masahirosuzuka/GC3/gc3.kicad_pcb

## KiCad design gc3.kicad_pcb (2017-02-18)

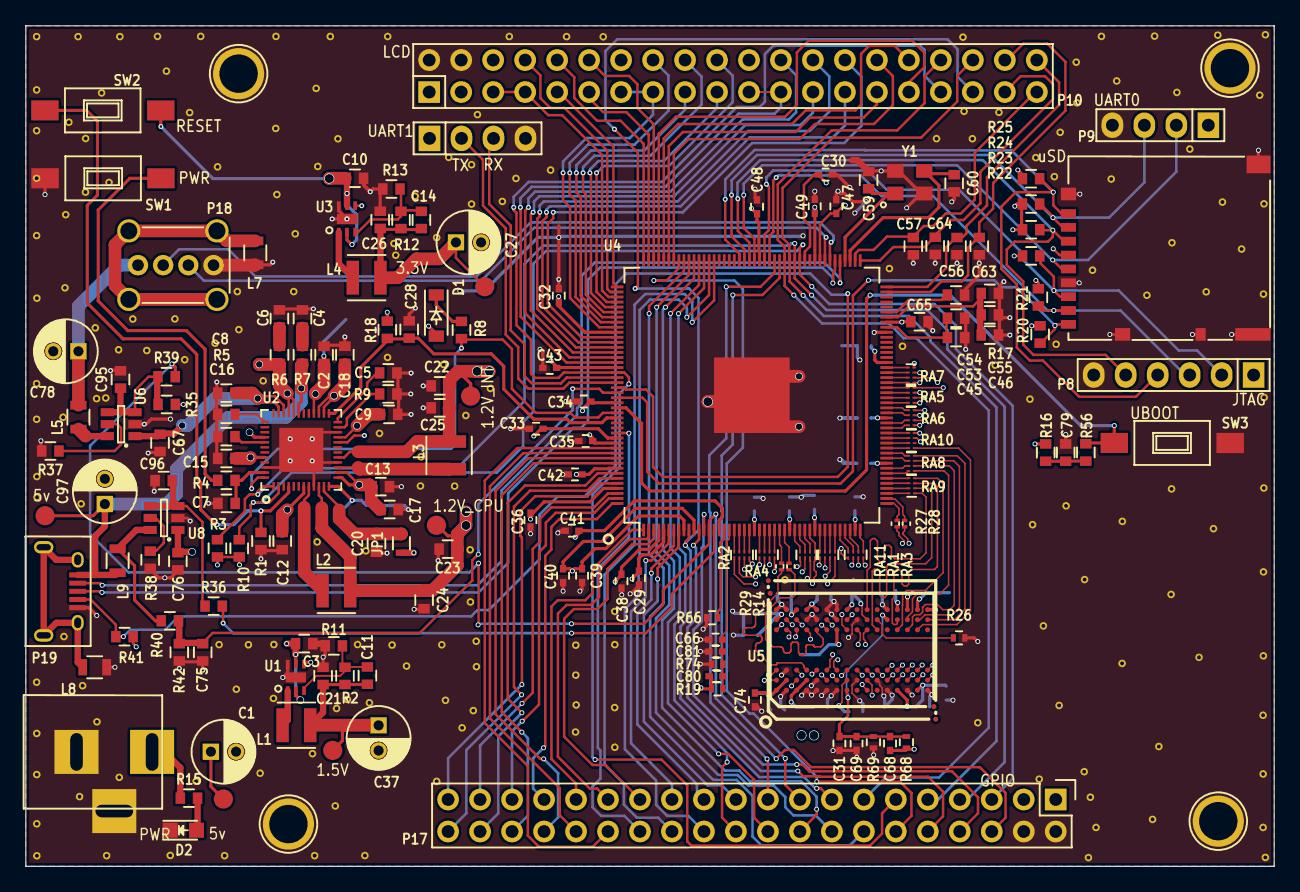
[picture p1: board gc3.kicad_pcb from above]

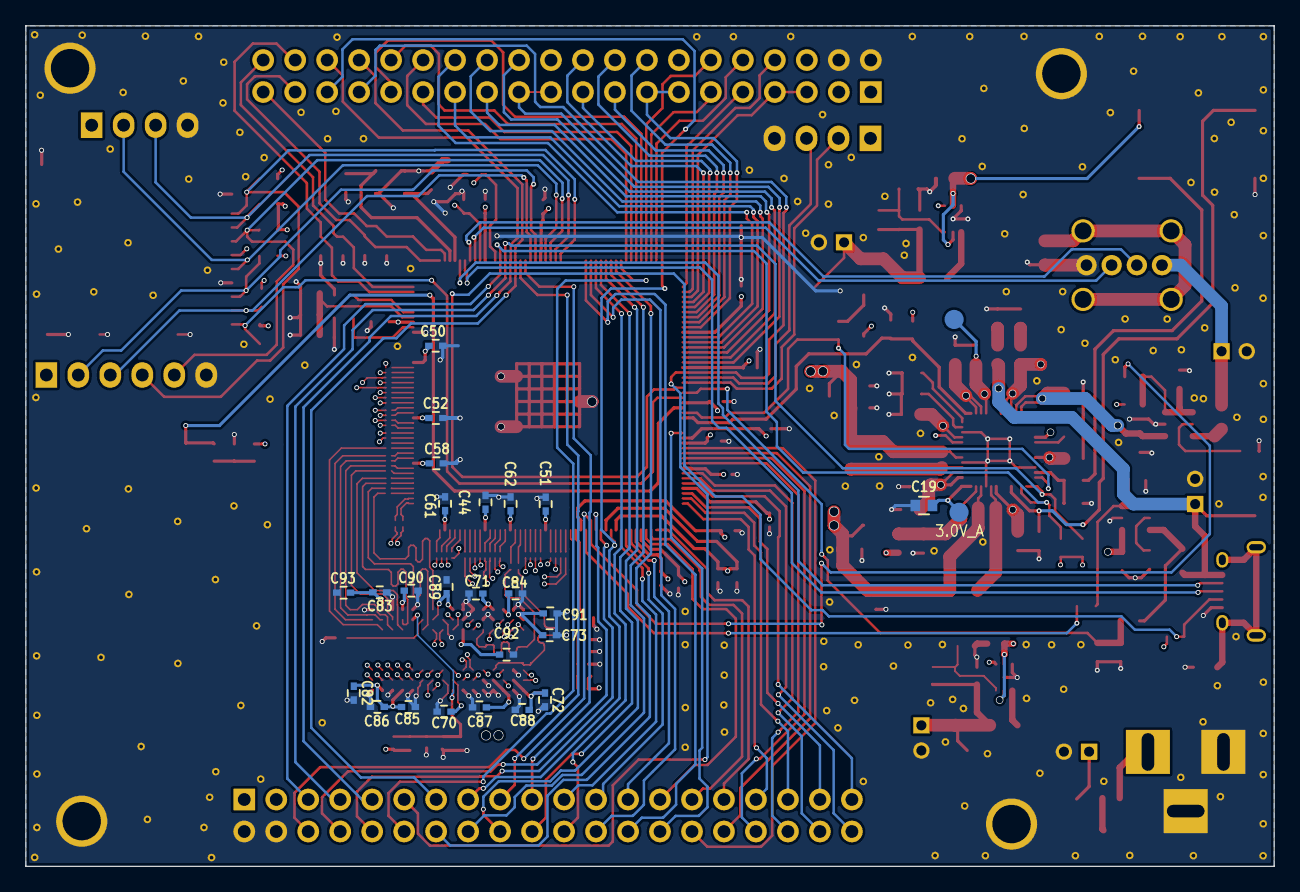
[picture p2: board gc3.kicad_pcb from below]

Board: 6 copper layers, 99.1 x 66.8 mm, 191 parts (26 on the bottom side), 225 nets.

Parts:
C1, C27, C37, C78, C97: 100uF; C_Radial_D5_L11_P2
C2, C9, C56, C57, C63, C64, C79: 1uF; Common_0603
C3, C10: 4.7uF; Common_0603
C4, C5, C6, C8, C12, C13, C15, C16, C17, C18, C19, C20, C22, C23, C55: 10uF/6.3V; Common_0603
C7, C24, C25: 1nF; Common_0603
C11, C14: 22pF; Common_0603
C21, C26: 10uF; Common_0603
C28, C67, C75, C76, C95, C96: 0.1uF; Common_0603
C29, C30, C32, C33, C34, C35, C38, C40, C43, C44, C52, C61: 0.1uF/6.3V; C_0402
C31, C47, C66, C68, C69, C70, C71, C72, C73, C74, C80, C81, C83, C84, C85, C86, C88, C89, C90, C91, C92, C93: 0.1uF; C_0402
C36, C39, C41, C48, C50, C58, C62: 10uF/6.3V; C_0402
C42, C49, C51, C82, C87: 22uF/6.3V; C_0402
C45, C46, C53, C54: 0.1uF/6.3V; Common_0603
C59, C60: 30pF; Common_0603
C65: 22uF/6.3V; Common_0603
D1: DIODE; SOD-123
D2: POWER; LED-0805
J1: JACK; BARREL_JACK
J2: DM3AT-SF-PEJM5
JP1: JUMPER; R_0603
L1, L2, L3, L4: 2.2uH; Neosid_Inductor_SMS-ME3015
L5, L7, L8, L9: FB/2A; R_0805
P1, P2, P3, P4, P5, P6, P15: TESTPOINT; Measurement_Point_Round-SMD-Pad_Small
P7: LCD; Pin_Header_Straight_2x20
P8: JTAG; Pin_Header_Straight_1x06
P9: UART0; Pin_Header_Straight_1x04
P10: UART1; Pin_Header_Straight_1x04
P11, P12, P13, P14: GND; 1pin
P16: TEESTPOINT; Measurement_Point_Round-SMD-Pad_Small
P17: GPIO; Pin_Header_Straight_2x20
P18: USB_A; USB_A_Vertical
P19: USB_OTG; USB_Micro-B
R1: 510R; Common_0603
R2: 315k; Common_0603
R3, R10: 2.2k; Common_0603
R4: 1k; Common_0603
R5: 240R/1%; Common_0603
R6, R7: 1R; Common_0603
R8, R18, R20, R21, R22, R23, R24, R25, R35, R41: 47k; Common_0603
R9, R17: 200k/1%; Common_0603
R11: 210k; Common_0603
R12, R36, R39: 100k; Common_0603
R13: 22k; Common_0603
R14, R29: 22R; R_0201
R15: 90R; Common_0603
R16: 100k/1%; Common_0603
R19, R68, R69, R74: 2k/1%; R_0402
R26, R66: 240R/1%; R_0402
R27, R28: 24R; R_0201
R37, R38: 20k; Common_0603
R40: 47K; Common_0603
R42: 100K; Common_0603
R56: 6.8k/1%; Common_0603
RA1, RA2, RA3, RA4, RA5, RA6, RA7, RA8, RA9, RA10, RA11: 22R; EXB18V
SW1: PWR_ON; SW_SPST_FSMSM
SW2: RESET; SW_SPST_FSMSM
SW3: UBOOT; SW_SPST_FSMSM
U1, U3: TPS62290
U2: axp209; TQFP-48-1EP_6x6mm_Pitch0.4mm
U4: a13; LQFP-176_20x20mm_Pitch0.4mm
U5: h5tq2g63bfr; FBGA96(HYNIX_SAMSUNG_512MX16_DDR3)
U6, U8: TPS2552; SOT-23-6
Y1: 24MHz/20pF/20ppm; ecx32

Connections:
1.2V_CPU: C23.1, C24.1, C34.1, C35.1, C36.1, C38.1, C39.1, C40.1, C41.1, C42.1, L2.2, P4.1, U2.10, U4.4, U4.9, U4.11, U4.16, U4.156, U4.164, U4.169, U4.173
1.2V_INT: C22.1, C25.1, C43.1, C44.1, C48.1, C49.1, C50.1, L3.2, P5.1, U2.17, U4.35, U4.73, U4.98, U4.109, U4.149
+1.5V: C11.1, C21.1, C37.1, C51.1, C52.1, C58.1, C61.1, C62.1, C68.1, C70.1, C71.1, C72.1, C73.1, C74.1, C80.1, C82.1, C83.1, C84.1, C85.1, C86.1, C87.1, C88.1, C89.1, C90.1, C91.1, C92.1, C93.1, L1.2, P6.1, R2.1, R19.1, R68.1, U4.23, U4.30, U4.43, U4.53, U4.62, U5.A1, U5.A8, U5.B2, U5.C1, U5.C9, U5.D2, U5.D9, U5.E9, U5.G7, U5.H2, U5.H9, U5.K2, U5.K8, U5.N1, U5.N9, U5.R1, U5.R9
+3.0VA: C19.2, C65.1, P3.1, R16.2, U1.4, U2.12, U4.81
+3V3: C14.1, C26.1, C27.1, C29.1, C30.1, C32.1, C33.1, C47.1, D1.2, J2.4, JP1.1, L4.2, P7.3, P8.1, P9.1, P10.1, P15.1, P17.3, R3.2, R10.2, R12.1, R18.2, R20.1, R21.1, R22.1, R23.1, R24.1, R25.1, R35.2, R41.1, U4.5, U4.97, U4.100, U4.142, U4.163
+5V: C1.1, J1.1, P7.1, P16.1, P17.1, R6.1, R15.1, U2.32, U2.33
/3V3_WIFI: C16.2, U2.41
/+5V_USB_OTG: C97.1, L9.2, P1.1, P19.1, R7.1, U2.31
/EXTEN: U2.20, U3.4
/NMI_N: R8.1, U2.48, U4.158
/RESET_N: C28.1, R18.1, U2.25, U4.159
/VDD_RTC: C18.2, P2.1, U2.28
/VINT: C2.1, U2.26, U2.27
/mpu_ddr3/A0: RA6.5, U5.N3
/mpu_ddr3/A1: RA8.7, U5.P7
/mpu_ddr3/A2: RA5.7, U5.P3
/mpu_ddr3/A3: RA5.8, U5.N2
/mpu_ddr3/A4: RA8.8, U5.P8
/mpu_ddr3/A5: RA5.6, U5.P2
/mpu_ddr3/A6: RA8.6, U5.R8
/mpu_ddr3/A7: RA7.6, U5.R2
/mpu_ddr3/A8: RA8.5, U5.T8
/mpu_ddr3/A9: RA7.8, U5.R3
/mpu_ddr3/A10: RA9.7, U5.L7
/mpu_ddr3/A11: RA10.8, U5.R7
/mpu_ddr3/A12: RA9.5, U5.N7
/mpu_ddr3/A13: RA5.5, U5.T3
/mpu_ddr3/BA0: RA6.6, U5.M2
/mpu_ddr3/BA1: RA9.6, U5.N8
/mpu_ddr3/BA2: RA6.7, U5.M3
/mpu_ddr3/CAS: RA10.5, U5.K3
/mpu_ddr3/CKE: RA9.8, U5.K9
/mpu_ddr3/CK_N: R28.1, U5.K7
/mpu_ddr3/CK_P: R27.1, U5.J7
/mpu_ddr3/D0: RA2.1, U5.E3
/mpu_ddr3/D1: RA3.8, U5.F7
/mpu_ddr3/D2: RA2.2, U5.F2
/mpu_ddr3/D3: RA3.7, U5.F8
/mpu_ddr3/D4: RA2.4, U5.H3
/mpu_ddr3/D5: RA3.5, U5.H8
/mpu_ddr3/D6: RA2.3, U5.G2
/mpu_ddr3/D7: RA3.6, U5.H7
/mpu_ddr3/D8: RA1.7, U5.D7
/mpu_ddr3/D9: RA4.7, U5.C3
/mpu_ddr3/D10: RA1.5, U5.C8
/mpu_ddr3/D11: RA4.8, U5.C2
/mpu_ddr3/D12: RA1.8, U5.A7
/mpu_ddr3/D13: RA4.6, U5.A2
/mpu_ddr3/D14: RA1.6, U5.B8
/mpu_ddr3/D15: RA4.5, U5.A3
/mpu_ddr3/DM0: R14.1, U5.E7
/mpu_ddr3/DM1: R29.1, U5.D3
/mpu_ddr3/DQS0_N: RA11.7, U5.G3
/mpu_ddr3/DQS0_P: RA11.8, U5.F3
/mpu_ddr3/DQS1_N: RA11.5, U5.B7
/mpu_ddr3/DQS1_P: RA11.6, U5.C7
/mpu_ddr3/LCD_CLK: P7.31, U4.129
/mpu_ddr3/LCD_D2: P7.21, P7.23, U4.148
/mpu_ddr3/LCD_D3: P7.24, U4.147
/mpu_ddr3/LCD_D4: P7.25, U4.146
/mpu_ddr3/LCD_D5: P7.26, U4.145
/mpu_ddr3/LCD_D6: P7.27, U4.144
/mpu_ddr3/LCD_D7: P7.28, U4.143
/mpu_ddr3/LCD_D10: P7.13, P7.15, U4.141
/mpu_ddr3/LCD_D11: P7.16, U4.140
/mpu_ddr3/LCD_D12: P7.17, U4.139
/mpu_ddr3/LCD_D13: P7.18, U4.138
/mpu_ddr3/LCD_D14: P7.19, U4.137
/mpu_ddr3/LCD_D15: P7.20, U4.136
/mpu_ddr3/LCD_D18: P7.5, P7.7, U4.135
/mpu_ddr3/LCD_D19: P7.8, U4.134
/mpu_ddr3/LCD_D20: P7.9, U4.133
/mpu_ddr3/LCD_D21: P7.10, U4.132
/mpu_ddr3/LCD_D22: P7.11, U4.131
/mpu_ddr3/LCD_D23: P7.12, U4.130
/mpu_ddr3/LCD_DE: P7.32, U4.128
/mpu_ddr3/LCD_HSYNC: P7.29, U4.127
/mpu_ddr3/LCD_VSYNC: P7.30, U4.126
/mpu_ddr3/ODT: RA7.5, U5.K1
/mpu_ddr3/PIN6/PWM0: P7.36, P17.9, U4.103
/mpu_ddr3/PIN7: P7.33, P17.11, U4.150
/mpu_ddr3/PIN8: P7.34, P17.13, U4.104
/mpu_ddr3/PIN9: P7.35, P17.15, U4.10
/mpu_ddr3/PIN10/TWI1-SCK: P17.17, U4.105
/mpu_ddr3/PIN11/TWI1-SDA: P17.19, U4.106
/mpu_ddr3/PIN12/NWE: P17.21, U4.8
/mpu_ddr3/PIN13/NALE: P17.23, U4.7
/mpu_ddr3/PIN14/NCLE: P17.25, U4.6
/mpu_ddr3/PIN15/NCE1: P17.27, U4.3
/mpu_ddr3/PIN16/NCE0: P17.29, U4.2
/mpu_ddr3/PIN17/NRE: P17.31, U4.1
/mpu_ddr3/PIN18/NRB0: P17.33, U4.176
/mpu_ddr3/PIN19/NRB1: P17.35, U4.175
/mpu_ddr3/PIN20/NDQ0: P17.37, U4.174
/mpu_ddr3/PIN21/NDQ1: P17.39, U4.172
/mpu_ddr3/PIN22/NDQ2: P17.40, U4.171
/mpu_ddr3/PIN23/NDQ3: P17.38, U4.170
/mpu_ddr3/PIN24/NDQ4: P17.36, U4.168
/mpu_ddr3/PIN25/NDQ5: P17.34, U4.167
/mpu_ddr3/PIN26/NDQ6: P17.32, U4.166
/mpu_ddr3/PIN27/NDQ7: P17.30, U4.165
/mpu_ddr3/PIN28/NDQS: P17.28, U4.162
/mpu_ddr3/PIN29: P17.26, U4.118
/mpu_ddr3/PIN30: P17.24, U4.119
/mpu_ddr3/PIN31: P17.22, U4.120
/mpu_ddr3/PIN32: P17.20, U4.121
/mpu_ddr3/PIN33: P17.18, U4.122
/mpu_ddr3/PIN34: P17.16, U4.123
/mpu_ddr3/PIN35: P17.14, U4.124
/mpu_ddr3/PIN36: P17.12, U4.125
/mpu_ddr3/PIN37: P17.10, U4.12
/mpu_ddr3/PIN38/VGA_DIS: P17.8, U4.13
/mpu_ddr3/PIN39/USBH_EN: P17.6, R39.2, U4.14
/mpu_ddr3/RAS: RA10.6, U5.J3
/mpu_ddr3/RESET: RA7.7, U5.T2
/mpu_ddr3/SA0: RA6.4, U4.64
/mpu_ddr3/SA1: RA8.2, U4.52
/mpu_ddr3/SA2: RA5.2, U4.66
/mpu_ddr3/SA3: RA5.1, U4.65
/mpu_ddr3/SA4: RA8.1, U4.51
/mpu_ddr3/SA5: RA5.3, U4.67
/mpu_ddr3/SA6: RA8.3, U4.54
/mpu_ddr3/SA7: RA7.3, U4.71
/mpu_ddr3/SA8: RA8.4, U4.55
/mpu_ddr3/SA9: RA7.1, U4.69
/mpu_ddr3/SA10: RA9.2, U4.48
/mpu_ddr3/SA11: RA10.1, U4.56
/mpu_ddr3/SA12: RA9.4, U4.50
/mpu_ddr3/SA13: RA5.4, U4.68
/mpu_ddr3/SA14: RA10.2, U4.57
/mpu_ddr3/SBA0: RA6.3, U4.63
/mpu_ddr3/SBA1: RA9.3, U4.49
/mpu_ddr3/SBA2: RA6.2, U4.61
/mpu_ddr3/SCAS: RA10.4, U4.59
/mpu_ddr3/SCKE: RA9.1, U4.47
/mpu_ddr3/SCK_N: R28.2, U4.46
/mpu_ddr3/SCK_P: R27.2, U4.45
/mpu_ddr3/SD0: RA2.8, U4.22
/mpu_ddr3/SD0_CARD_DETECT: J2.9, R20.2, U4.155
/mpu_ddr3/SD1: RA3.1, U4.40
/mpu_ddr3/SD2: RA2.7, U4.21
/mpu_ddr3/SD3: RA3.2, U4.41
/mpu_ddr3/SD4: RA2.5, U4.19
/mpu_ddr3/SD5: RA3.4, U4.44
/mpu_ddr3/SD6: RA2.6, U4.20
/mpu_ddr3/SD7: RA3.3, U4.42
/mpu_ddr3/SD8: RA1.2, U4.37
/mpu_ddr3/SD9: RA4.2, U4.25
/mpu_ddr3/SD10: RA1.4, U4.39
/mpu_ddr3/SD11: RA4.1, U4.24
/mpu_ddr3/SD12: RA1.1, U4.36
/mpu_ddr3/SD13: RA4.3, U4.26
/mpu_ddr3/SD14: RA1.3, U4.38
/mpu_ddr3/SD15: RA4.4, U4.27
/mpu_ddr3/SDC0_CMD: J2.3, P8.5, R23.2, U4.111
/mpu_ddr3/SDC0_DATA0: J2.7, P8.2, R22.2, U4.108
/mpu_ddr3/SDC0_DATA1: J2.8, P8.3, R21.2, U4.107
/mpu_ddr3/SDC0_DATA2: J2.1, P8.4, R25.2, U4.113
/mpu_ddr3/SDC0_DATA3: J2.2, P9.3, R24.2, U4.112
/mpu_ddr3/SDC0_SCK: J2.5, P9.2, U4.110
/mpu_ddr3/SDM0: R14.2, U4.29
/mpu_ddr3/SDM1: R29.2, U4.28
/mpu_ddr3/SDQS0_N: RA11.2, U4.32
/mpu_ddr3/SDQS0_P: RA11.1, U4.31
/mpu_ddr3/SDQS1_N: RA11.4, U4.34
/mpu_ddr3/SDQS1_P: RA11.3, U4.33
/mpu_ddr3/SODT: RA7.4, U4.72
/mpu_ddr3/SRAS: RA10.3, U4.58
/mpu_ddr3/SRESET: RA7.2, U4.70
/mpu_ddr3/SVREF: C66.2, C80.2, C81.1, R19.2, R74.1, U4.18
/mpu_ddr3/SWE: RA6.1, U4.60
/mpu_ddr3/TPX1: C64.1, P7.37, U4.89
/mpu_ddr3/TPX2: C63.1, P7.38, U4.87
/mpu_ddr3/TPY1: C57.1, P7.39, U4.90
/mpu_ddr3/TPY2: C56.1, P7.40, U4.88
/mpu_ddr3/UART1_RX: P10.3, U4.151
/mpu_ddr3/UART1_TX: P10.2, U4.152
/mpu_ddr3/UBOOT: R56.1, SW3.2, U4.157
/mpu_ddr3/UDM0: P19.2, U4.93
/mpu_ddr3/UDM1: P18.2, U4.95
/mpu_ddr3/UDP0: P19.3, U4.94
/mpu_ddr3/UDP1: P18.3, U4.96
/mpu_ddr3/USB0_DRV: R36.2, U4.15
/mpu_ddr3/USB0_IDDET: P19.4, R41.2, U4.153
/mpu_ddr3/USB0_VBUSDET: C75.1, R40.2, R42.1, U4.154
/mpu_ddr3/VREF: C31.1, C68.2, C69.1, R68.2, R69.1, U5.H1, U5.M8
/mpu_ddr3/WE: RA6.8, U5.L3
GND: C1.2, C2.2, C3.2, C4.2, C5.2, C6.2, C7.2, C8.2, C9.2, C10.2, C12.1, C13.1, C15.1, C16.1, C17.1, C18.1, C19.1, C20.1, C21.2, C22.2, C23.2, C24.2, C25.2, C26.2, C27.2, C28.2, C29.2, C30.2, C31.2, C32.2, C33.2, C34.2, C35.2, C36.2, C37.2, C38.2, C39.2, C40.2, C41.2, C42.2, C43.2, C44.2, C45.2, C46.2, C47.2, C48.2, C49.2, C50.2, C51.2, C52.2, C53.2, C54.2, C55.2, C56.2, C57.2, C58.2, C59.2, C60.2, C61.2, C62.2, C63.2, C64.2, C65.2, C66.1, C67.2, C69.2, C70.2, C71.2, C72.2, C73.2, C74.2, C75.2, C76.2, C78.2, C79.2, C81.2, C82.2, C83.2, C84.2, C85.2, C86.2, C87.2, C88.2, C89.2, C90.2, C91.2, C92.2, C93.2, C95.2, C96.2, C97.2, D2.1, J1.2, J1.3, J2.6, J2.10, J2.11, L7.1, L8.1, P7.2, P7.4, P8.6, P9.4, P10.4, P11.1, P12.1, P13.1, P14.1, P17.2, P17.4, P18.4, P19.5, R1.2, R5.2, R9.2, R11.2, R13.2, R17.2, R26.2, R37.2, R38.2, R42.2, R66.1, R69.2, R74.2, SW1.1, SW3.1, U1.6, U2.9, U2.16, U2.22, U2.46, U2.49, U3.6, U4.79, U4.177, U5.A9, U5.B1, U5.B3, U5.B9, U5.D1, U5.D8, U5.E1, U5.E2, U5.E8, U5.F1, U5.F9, U5.G1, U5.G8, U5.G9, U5.J2, U5.J8, U5.L2, U5.M1, U5.M9, U5.P1, U5.P9, U5.T1, U5.T9, U6.2, U8.2, Y1.2, Y1.4
IPSOUT: C3.1, C8.1, C9.1, C10.1, C12.2, C13.2, C15.2, C17.2, C67.1, C76.1, SW2.1, U1.2, U1.5, U2.7, U2.13, U2.14, U2.21, U2.34, U2.35, U2.40, U2.44, U3.2, U3.5, U6.1, U8.1
unnamed: C4.1, R7.2
unnamed: C5.1, U2.24
unnamed: C6.1, R6.2
unnamed: C7.1, R4.1, U2.47
unnamed: C11.2, R2.2, R11.1, U1.3
unnamed: C14.2, R12.2, R13.1, U3.3
unnamed: C20.2, JP1.2, U2.11
unnamed: C45.1, C53.1, U4.80
unnamed: C46.1, C55.1, R17.1, U4.82
unnamed: C54.1, U4.83
unnamed: C59.1, U4.92, Y1.1
unnamed: C60.1, U4.91, Y1.3
unnamed: C78.1, L5.2, P18.1
unnamed: C79.1, R16.1, R56.2
unnamed: C95.1, R35.1, R39.1, U6.3, U6.4
unnamed: C96.1, R36.1, U8.3, U8.4
unnamed: D1.1, R8.2
unnamed: D2.2, R15.2
unnamed: L1.1, U1.1
unnamed: L2.1, U2.8
unnamed: L3.1, U2.15
unnamed: L4.1, U3.1
unnamed: L5.1, U6.6
unnamed: L7.2, P18.5
unnamed: L8.2, P19.6
unnamed: L9.1, R40.1, U8.6
unnamed: R1.1, SW2.2, U2.4
unnamed: R4.2, SW1.2
unnamed: R5.1, U2.37
unnamed: R9.1, U2.23
unnamed: R26.1, U5.L8
unnamed: R37.1, U6.5
unnamed: R38.1, U8.5
unnamed: R66.2, U4.17
PIN4/TWI0-SCK: P17.5, R10.1, U2.2, U4.101
PIN5/TWI0-SDA: P17.7, R3.1, U2.1, U4.102
