masahirosuzuka/GC3/(commit log)

2015-10-07 clean sch and add resistor array
    [gc3.kicad_pcb, gc3.sch, mpu_ddr3.sch]
2016-04-02 commit before cleanup all footprint
    [gc3.kicad_pcb, gc3.sch, mpu_ddr3.sch]
2016-04-03 clean: all footprint
    [gc3.kicad_pcb, mpu_ddr3.sch]
2016-07-31 Fix : bug fix
    [gc3.kicad_pcb, gc3.sch, mpu_ddr3.sch]
2016-09-02 Temp : Temp commit for before Update4
    [gc3.kicad_pcb, gc3.sch, mpu_ddr3.sch]
2016-09-24 Temp : temo commit for finish DDR3 routing
    [gc3.kicad_pcb, mpu_ddr3.sch]
2016-10-02 Temp : temp commit, finish routing for Update4
    [gc3.kicad_pcb, mpu_ddr3.sch]
2016-10-10 Add : finish Update$
    [gc3.kicad_pcb, mpu_ddr3.sch]
2016-11-20 Commit before production Update4
    [gc3.csv, gc3.kicad_pcb, mpu_ddr3.sch]
2016-12-10 temp : commit before change 8 layer
    [gc3.kicad_pcb]
2017-02-17 Fix : fix line width for impedance matching
    [gc3.kicad_pcb, gc3.sch, mpu_ddr3.sch]
2017-02-18 Hotfix : Fix solid ground issue
    [gc3.kicad_pcb]
2017-02-18 Hotfix : Fix solid ground issue panelize
2017-03-01 Temp : temp commit before fix 100uF capacitor pads
